Veriqloud/kiwi_pcb/README.md

# kiwi_pcb

Source code for the printed circuit boards. Open with KiCad. 

Contributing
------------

Please check out our [contributing guide](CONTRIBUTING.md) if you're interested in contributing.
