Veriqloud/kiwi_pcb/supply_interface/Production/supply_interface.csv

Source: | /home/lyes/kiwi_pcb/supply_interface/supply_interface.kicad_sch
Date: | Thu 11 Jun 2026 03:27:28 PM CEST
Tool: | Eeschema 7.0.11+dfsg-1build4
Generator: | /usr/share/kicad/plugins/bom_csv_grouped_by_value.py
Component Count: | 59
Collated Components:
Item | Qty | Reference(s) | Value | LibPart | Footprint | Datasheet | DNP | Arrow Part Number | Arrow Price/Stock | Description | Height | Manufacturer_Name | Manufacturer_Part_Number | Mouser Part Number | Mouser Price/Stock
1 | 8 | C1, C2, C11, C14, C17, C20, C23, C26 | 100 uF | T55D107M025C0060:T55D107M025C0060 | CAPPM7343X310N | https://www.mouser.in/datasheet/2/427/VISH_S_A0011791766_1-2571805.pdf |  |  |  | Tantalum Capacitors - Polymer 100uF 25volts 20% D Case 60 Max.ESR | 3.1 | Vishay | T55D107M025C0060 | 74-T55D107M025C0060 | https://www.mouser.co.uk/ProductDetail/Vishay-Sprague/T55D107M025C0060?qs=iR2ablhfrmEk%252B%2Fi%2Ffn01KQ%3D%3D
2 | 2 | C3, C4 | CL21A226MAYNNNE | CL21A226MAYNNNE:CL21A226MAYNNNE | CAPC2012X145N | http://product.samsungsem.com/mlcc/CL21A226MAYNNN.do |  |  |  | Multilayer Ceramic Capacitors MLCC - SMD/SMT 22uF+/-20% 25V X5R 2012 | 1.45 | SAMSUNG | CL21A226MAYNNNE | 187-CL21A226MAYNNNE | https://www.mouser.co.uk/ProductDetail/Samsung-Electro-Mechanics/CL21A226MAYNNNE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
3 | 6 | C9, C12, C15, C18, C21, C24 | 1 uF | GRM155R6YA105ME11J:GRM155R6YA105ME11J | GRM15x | https://search.murata.co.jp/Ceramy/image/img/A01X/G101/ENG/GRM155R6YA105ME11-01A.pdf |  |  |  |  | 0.33 | Murata Electronics | GRM155R6YA105ME11J | 81-GRM155R6YA105ME1J | https://www.mouser.co.uk/ProductDetail/Murata-Electronics/GRM155R6YA105ME11J?qs=F5EMLAvA7IDJM4M38SocmA%3D%3D
4 | 6 | C10, C13, C16, C19, C22, C25 | 22 uF | CL21A226MAYNNNE:CL21A226MAYNNNE | CAPC2012X145N | http://product.samsungsem.com/mlcc/CL21A226MAYNNN.do |  |  |  | Multilayer Ceramic Capacitors MLCC - SMD/SMT 22uF+/-20% 25V X5R 2012 | 1.45 | SAMSUNG | CL21A226MAYNNNE | 187-CL21A226MAYNNNE | https://www.mouser.co.uk/ProductDetail/Samsung-Electro-Mechanics/CL21A226MAYNNNE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
5 | 5 | D1, D2, D3, D4, D5 | TVS 12V | ATV02W150-HF:ATV02W150-HF | SODFL3718X130N | https://www.comchiptech.com/admin/files/product/ATV02W-HF%20series%20RevC.pdf |  |  |  |  | 1.3 | Comchip Technology | ATV02W150-HF | 750-ATV02W150-HF | https://www.mouser.co.uk/ProductDetail/Comchip-Technology/ATV02W150-HF?qs=vdiGlTBG6JsN1%252BHxsccr7w%3D%3D
6 | 1 | D6 | SMF6V0TR | SMF6V0TR:SMF6V0TR | SMF6V0TR | https://fscdn.rohm.com/en/products/databook/datasheet/discrete/diode/zener/smf6v0tr-e.pdf |  |  |  |  | 0.9 | ROHM Semiconductor | SMF6V0TR | 755-SMF6V0TR | https://www.mouser.co.uk/ProductDetail/ROHM-Semiconductor/SMF6V0TR/?qs=HXFqYaX1Q2yrPonInUPTeA%3D%3D
7 | 1 | D7 | DFLT27A-7 | DFLT27A-7:DFLT27A-7 | DFLT27A7 | https://www.diodes.com//assets/Datasheets/DFLT5V0A_DFLT220A.pdf |  |  |  |  | 1 | Diodes Incorporated | DFLT27A-7 | 621-DFLT27A-7 | https://www.mouser.co.uk/ProductDetail/Diodes-Incorporated/DFLT27A-7?qs=6ARB0lp6jlVvGDG5Fitq6g%3D%3D
8 | 1 | F1 | SF-0603S100-2 | SF-0603S100-2:SF-0603S100-2 | FUSC1608X55N | https://www.arrow.com/en/products/sf-0603s100-2/bourns |  |  |  |  | 0.55 | Bourns | SF-0603S100-2 | 652-SF-0603S100-2 | https://www.mouser.co.uk/ProductDetail/Bourns/SF-0603S100-2?qs=GIQXYiEeHGDLNhFbhYWnxw%3D%3D
9 | 1 | F2 | 3403.0157.24 | 3403.0157.24:3403.0157.24 | 3403015724 | https://www.schurter.com/en/datasheet/UMT_250 |  |  |  |  | 3 | SCHURTER | 3403.0157.24 | 693-3403.0157.24 | https://www.mouser.co.uk/ProductDetail/Schurter/3403015724/?qs=NiH9xeYC%252BKjhNprJ4TsRCQ%3D%3D
10 | 1 | F3 | SF-1206S300-2 | SF-1206S300-2:SF-1206S300-2 | FUSC3116X70N | https://www.arrow.com/en/products/sf-1206s400-2/bourns |  |  |  |  | 0.7 | Bourns | SF-1206S300-2 | 652-SF-1206S300-2 | https://www.mouser.co.uk/ProductDetail/Bourns/SF-1206S300-2?qs=GIQXYiEeHGDYZ4XcjkatwA%3D%3D
11 | 1 | F4 | SF-1206S1000R-2 | SF-1206S1000R-2:SF-1206S1000R-2 | FUSC3216X90N | https://www.bourns.com/docs/Product-Datasheets/SF-1206S-R.pdf |  |  |  |  | 0.9 | Bourns | SF-1206S1000R-2 | 652-SF-1206S1000R-2 | https://www.mouser.co.uk/ProductDetail/Bourns/SF-1206S1000R-2?qs=QpmGXVUTftGXxpZRDDQNPQ%3D%3D
12 | 1 | F5 | 049401.5NRHF | 049401_5NRHF:049401.5NRHF | 0494015NRHF | https://componentsearchengine.com/Datasheets/1/049401.5NRHF.pdf |  |  |  |  | 0.305 | LITTELFUSE | 049401.5NRHF | 576-049401.5NRHF | https://www.mouser.com/Search/Refine.aspx?Keyword=576-049401.5NRHF
13 | 1 | F6 | 0494002.NRHF | 0494002_NRHF:0494002.NRHF | FUSC1608X30N | http://www.littelfuse.com/~/media/electronics/datasheets/fuses/littelfuse_fuse_494_datasheet.pdf.pdf |  |  |  |  | 0.305 | LITTELFUSE | 0494002.NRHF | 576-0494002.NRHF | https://www.mouser.co.uk/ProductDetail/Littelfuse/0494002.NRHF?qs=zMpzAB%2FftDdhMQDursUq6Q%3D%3D
14 | 2 | F7, F11 | 3413.0329.22 | 3413.0329.22:3413.0329.22 | FUSC3216X60N | https://www.schurter.com/en/datasheet/UST_1206 |  |  |  |  | 0.6 | SCHURTER | 3413.0329.22 | 693-3413.0329.22 | https://www.mouser.co.uk/ProductDetail/Schurter/3413032922?qs=tk5EcTX4n4wCoEf0rBtliQ%3D%3D
15 | 2 | F8, F10 | 0ABA-0200-TN | 0ABA-0200-TN:0ABA-0200-TN | 0ABA0200TN | https://www.mouser.fr/datasheet/3/191/1/ds_cp_0aba_series.pdf |  |  |  |  | 0.5 | Bel Circuit Protection | 0ABA-0200-TN
16 | 1 | F9 | SF-0603SP080-2 | SF-0603SP080-2:SF-0603SP080-2 | FUSC1608X55N | https://www.mouser.fr/datasheet/3/40/1/SF_0603SP.pdf |  | SF-0603SP080-2 | https://www.arrow.com/en/products/sf-0603sp080-2/bourns?region=nac |  | 0.55 | Bourns | SF-0603SP080-2 | 652-SF-0603SP080-2 | https://www.mouser.co.uk/ProductDetail/Bourns/SF-0603SP080-2?qs=pxDZlBjcsChFLlq9LzvJZQ%3D%3D
17 | 4 | H1, H2, H3, H4 | MountingHole | Mechanical:MountingHole | MountingHole:MountingHole_3mm_Pad_Via | ~
18 | 1 | J1 | 39-28-1243 | 39-28-1243:39-28-1243 | 39-28-1243 | https://www.molex.com/pdm_docs/sd/039281023_sd.pdf |  |  |  | 24 way vertical PCB header,Mini-Fit Jr Molex MINI-FIT JR. Series, Series Number 5566, 4.2mm Pitch 24 Way 2 Row Straight PCB Header, Solder Termination, 6A | 12.8 | Molex | 39-28-1243 | 538-39-28-1243 | https://www.mouser.co.uk/ProductDetail/Molex/39-28-1243?qs=4XSMV6Twtb0I%2F4%252BTTSJFbg%3D%3D
19 | 2 | J2, J7 | 39-28-1043 | 39-28-1043:39-28-1043 | 39-28-1043 | https://www.molex.com/pdm_docs/sd/039281023_sd.pdf |  |  |  | Mini-Fit Jr. Vertical Header, 4.20mm Pitch, Dual Row, 4 Circuits, without Snap-in Plastic Peg PCB Lock, Tin, Natural | 12.8 | Molex | 39-28-1043 | 538-39-28-1043 | https://www.mouser.co.uk/ProductDetail/Molex/39-28-1043?qs=LQQHZ4xw2XCMHoV0KRLGhg%3D%3D
20 | 9 | J3, J4, J6, J8, J9, J10, J11, J12, J13 | MBES-152 | MBES-152:MBES-152 | CONN_MBES-152_ALT | MBES-152
21 | 1 | J5 | 282837-3 | 282837-3:282837-3 | 2828373 |  |  |  |  | Fixed Terminal Blocks 5.08MM PCB MOUNT 3P | 10.3 | TE Connectivity | 282837-3 | 571-2828373 | https://www.mouser.co.uk/ProductDetail/TE-Connectivity/282837-3?qs=A%252Bip%252BNCYi6PMRxtBYEOSrQ%3D%3D
22 | 1 | J15 | 3-641215-2 | 3-641215-2:3-641215-2 | SHDR2W66P0X254_1X2_508X572X813P | http://www.te.com/usa-en/product-3-641215-2.html#guest-click |  |  |  |  | 8.128 | TE Connectivity | 3-641215-2 | 571-3-641215-2 | https://www.mouser.co.uk/ProductDetail/TE-Connectivity-AMP/3-641215-2?qs=KRfK61YovsgAMFXR0HUBMw%3D%3D
23 | 1 | PS1 | TEL_15-1215N | TEL_15-1215N:TEL_15-1215N | TEL151215N | https://tracopower.com/tel15n-datasheet/ |  |  |  | 15 Watt DC/DC converter, industrial, 2:1 input, ultra compact design, encapsulated, DIP-16 metal package | 10.7 | Traco Power | TEL 15-1215N | 495-TEL15-1215N | https://www.mouser.co.uk/ProductDetail/TRACO-Power/TEL-15-1215N?qs=T%252BzbugeAwjjLZBJJlIkfGQ%3D%3D
