Veriqloud/kiwi_pcb/MB/3D/TEN_40-2422E.stp

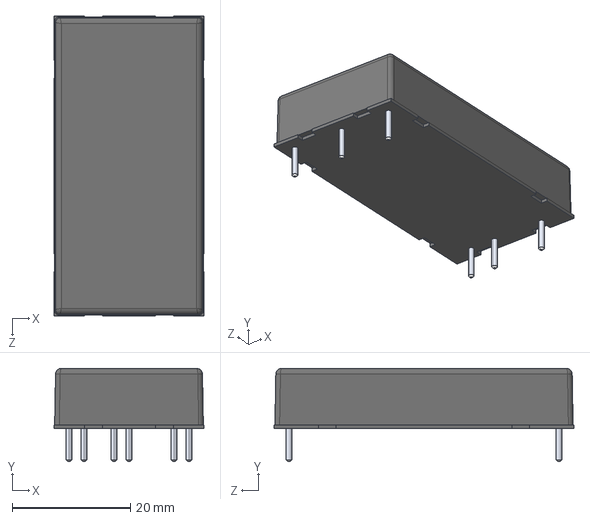
[picture p1: CAD file, 2024-12-13]
MB/3D/TEN_40-2422E.stp
25.4 x 15.8 x 50.8 mm
