Veriqloud/kiwi_pcb/MB/3D/T55D107M025C0060.stp

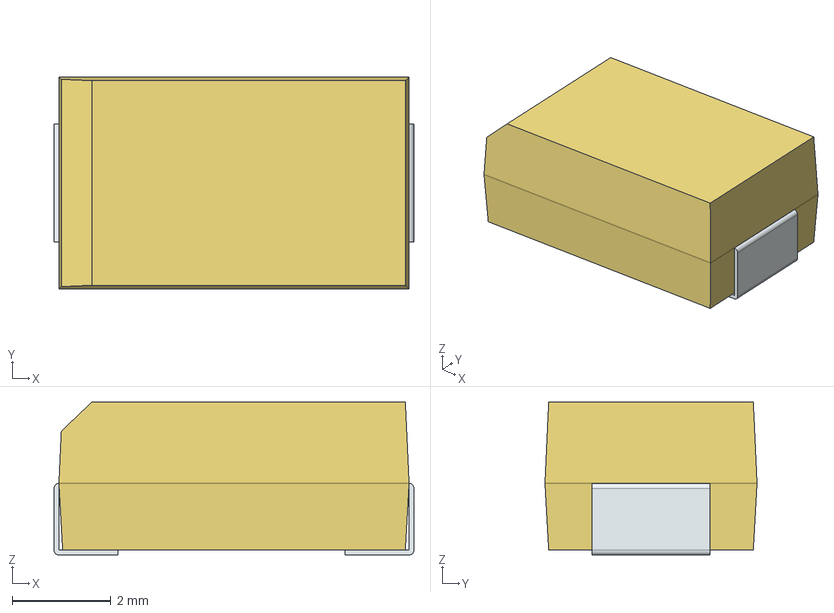
[picture p2: CAD file, 2024-12-13]
MB/3D/T55D107M025C0060.stp
7.30 x 4.30 x 3.10 mm
FilletPin1
FilletPin2
