Veriqloud/kiwi_pcb/MB/3D/PQQ10W-Q24-S3-S.stp

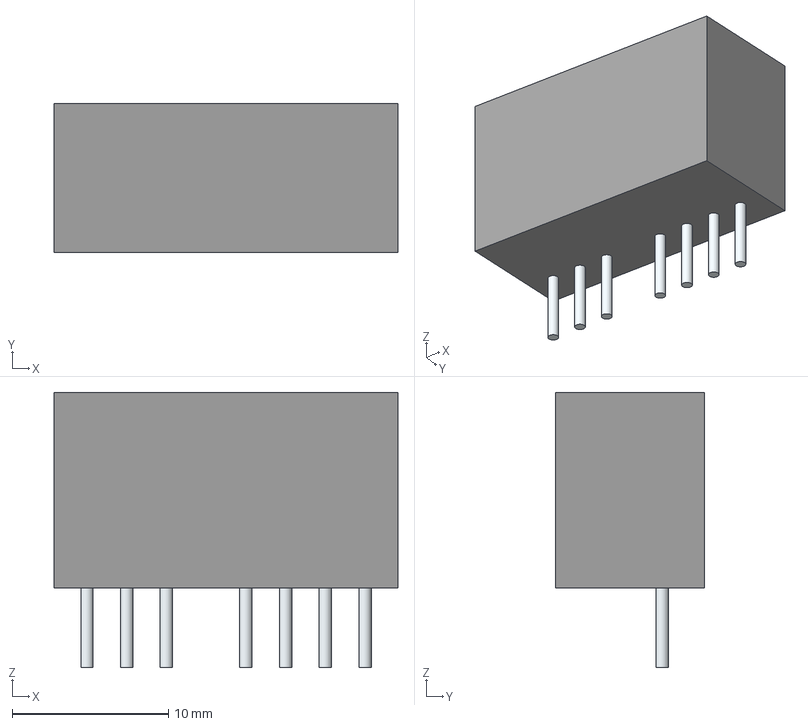
[picture p3: CAD file, 2024-12-13]
MB/3D/PQQ10W-Q24-S3-S.stp
22.0 x 9.50 x 17.6 mm
Leads
