Veriqloud/kiwi_pcb/MB/3D/39-28-1043.stp

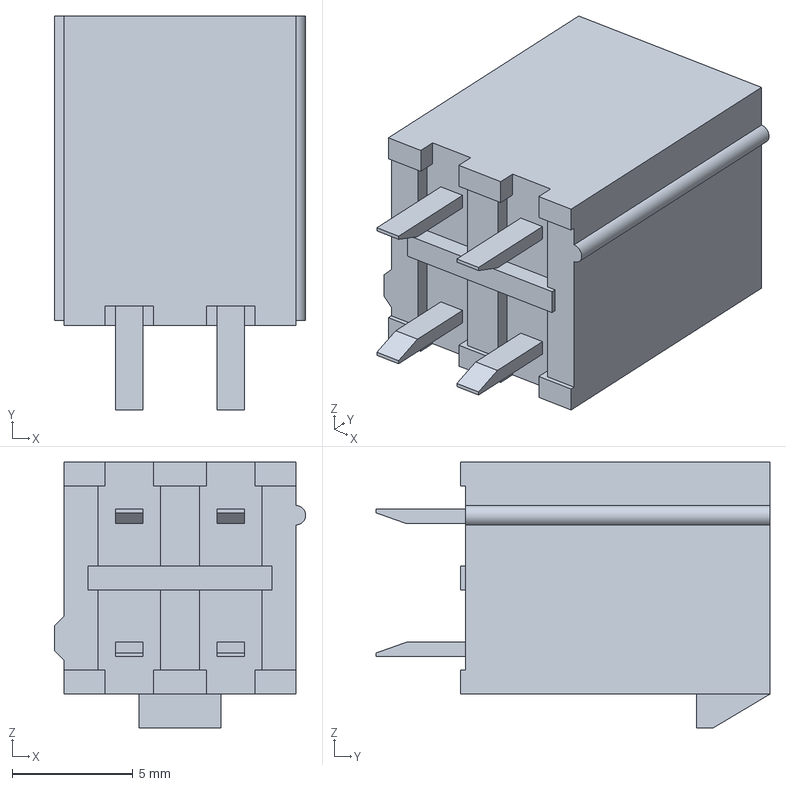
[picture p4: CAD file, 2024-12-13]
MB/3D/39-28-1043.stp
10.4 x 16.3 x 11.0 mm
