Veriqloud/kiwi_pcb/MB/3D/GRM31CR61E476ME44K.stp

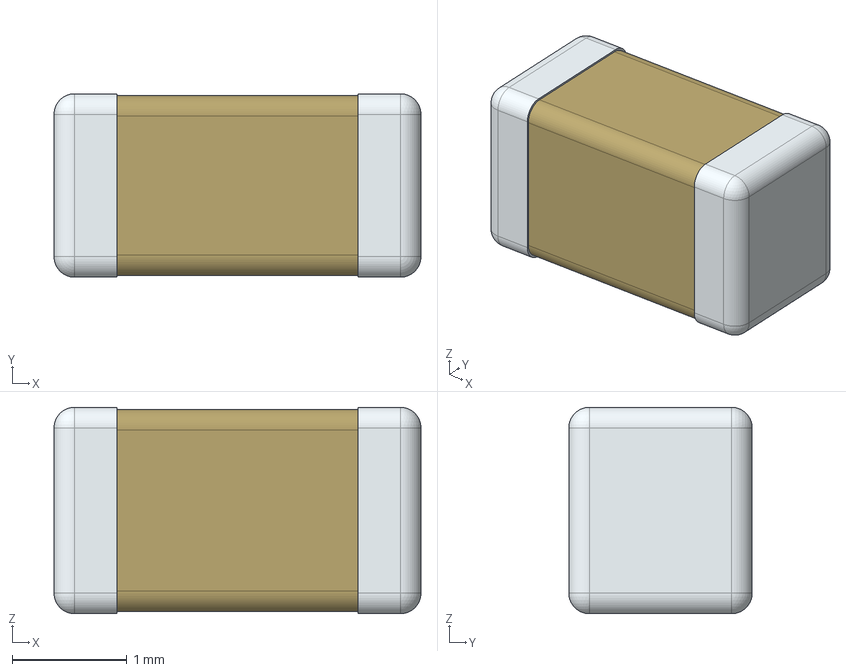
[picture p5: CAD file, 2024-12-13]
MB/3D/GRM31CR61E476ME44K.stp
3.20 x 1.60 x 1.80 mm
