Veriqloud/kiwi_pcb/MB/3D/GRM21BR61E226ME44K.stp

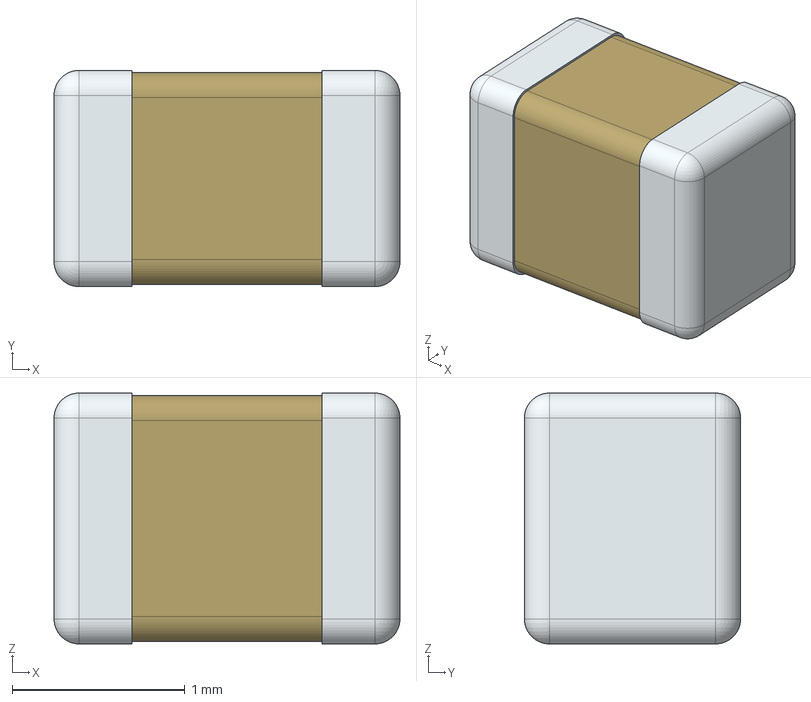
[picture p6: CAD file, 2024-12-13]
MB/3D/GRM21BR61E226ME44K.stp
2.00 x 1.25 x 1.45 mm
