Veriqloud/kiwi_pcb/MB/3D/PDQE15-Q24-S5-D.stp

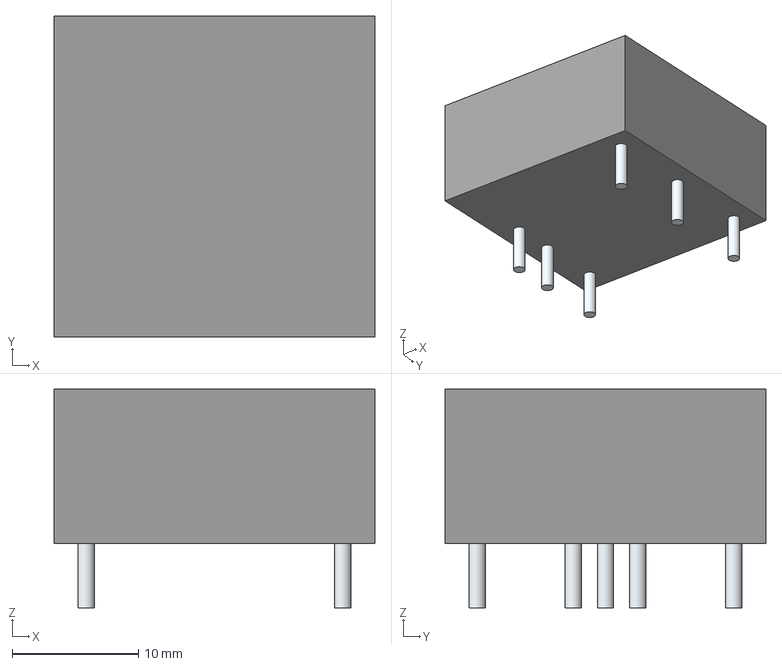
[picture p7: CAD file, 2024-12-13]
MB/3D/PDQE15-Q24-S5-D.stp
25.4 x 25.4 x 17.3 mm
Leads
