Veriqloud/kiwi_pcb/MB/3D/PJ-082BH.stp

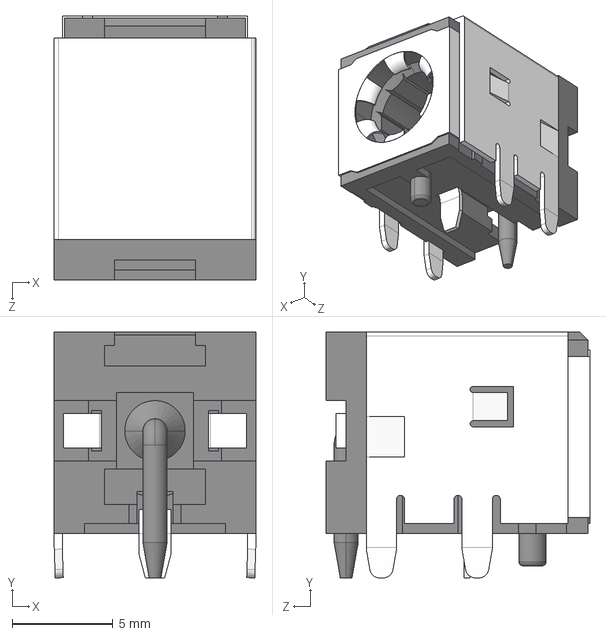
[picture p8: CAD file, 2024-12-13]
MB/3D/PJ-082BH.stp
10.0 x 12.2 x 13.1 mm
