Veriqloud/kiwi_pcb/MB/3D/TEL_15-1215N.stp

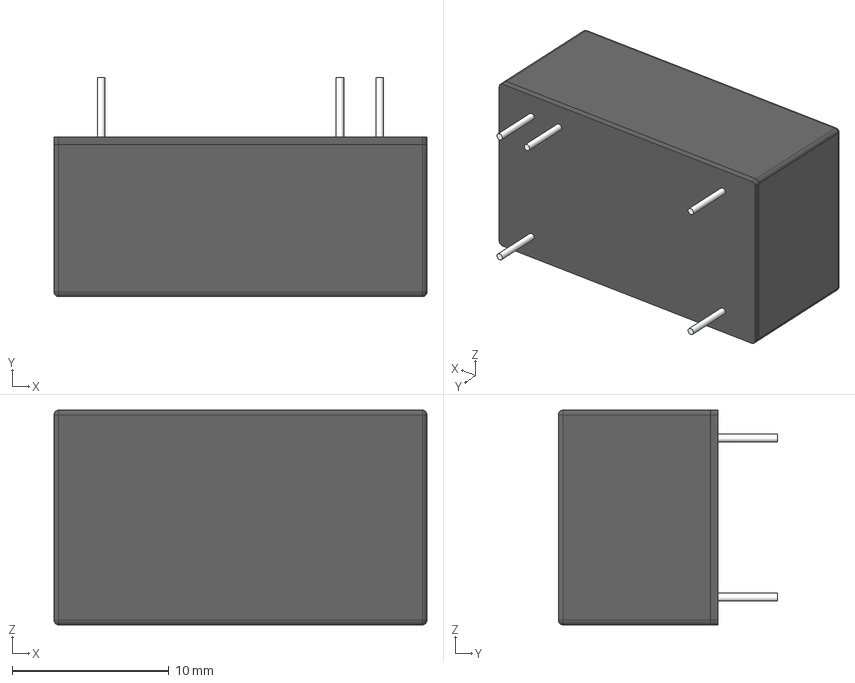
[picture p9: CAD file, 2024-12-13]
MB/3D/TEL_15-1215N.stp
23.8 x 14.0 x 13.7 mm
