Veriqloud/kiwi_pcb/MB/3D/UWT1V221MNL1GS.stp

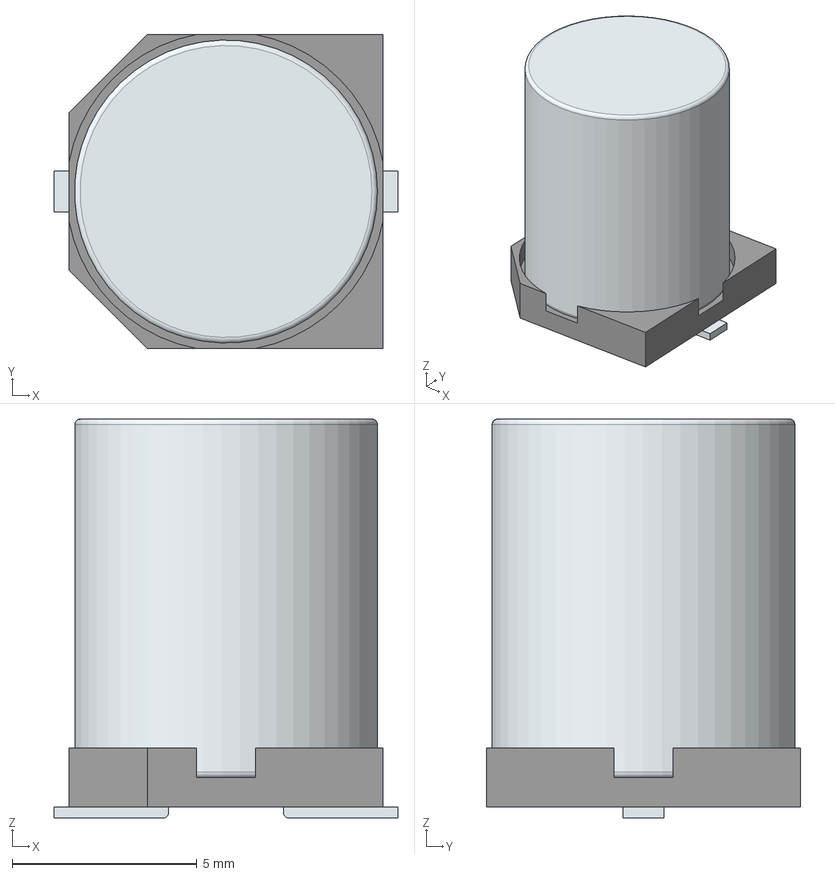
[picture p10: CAD file, 2024-12-13]
MB/3D/UWT1V221MNL1GS.stp
9.30 x 8.50 x 10.8 mm
Base
Pin1Fillet
Pin2Fillet
