Veriqloud/kiwi_pcb/MB/3D/39-28-1243.stp

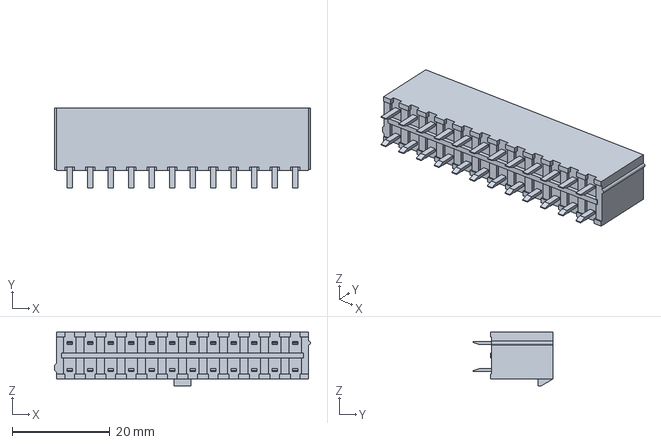
[picture p11: CAD file, 2024-12-13]
MB/3D/39-28-1243.stp
52.4 x 16.3 x 11.0 mm
