Veriqloud/kiwi_pcb/MB/3D/282837-3.stp

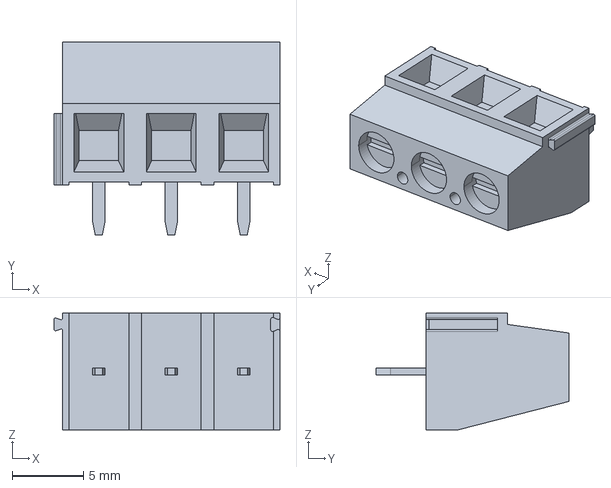
[picture p12: CAD file, 2024-12-13]
MB/3D/282837-3.stp
15.8 x 13.5 x 8.20 mm
