Veriqloud/kiwi_pcb/MB/3D/10127820-0821LF.stp

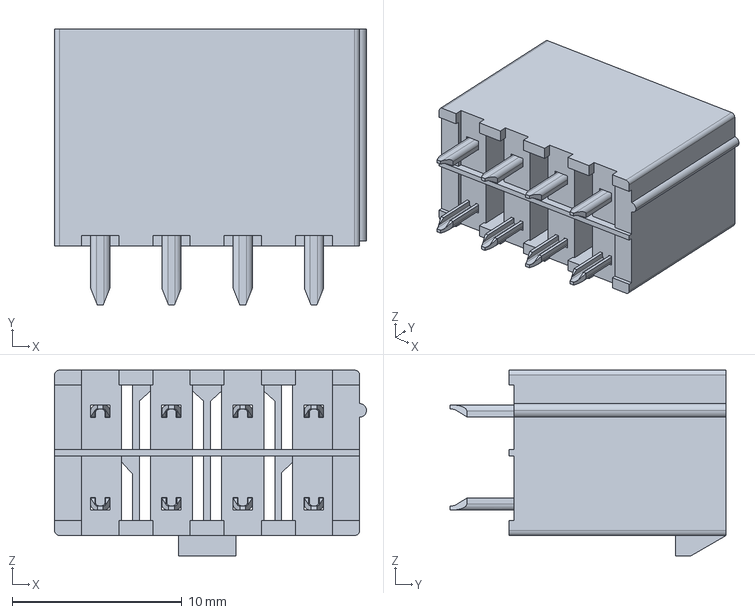
[picture p13: CAD file, 2024-12-13]
MB/3D/10127820-0821LF.stp
18.4 x 16.3 x 11.0 mm
