Veriqloud/kiwi_pcb/MB/3D/1725656.stp

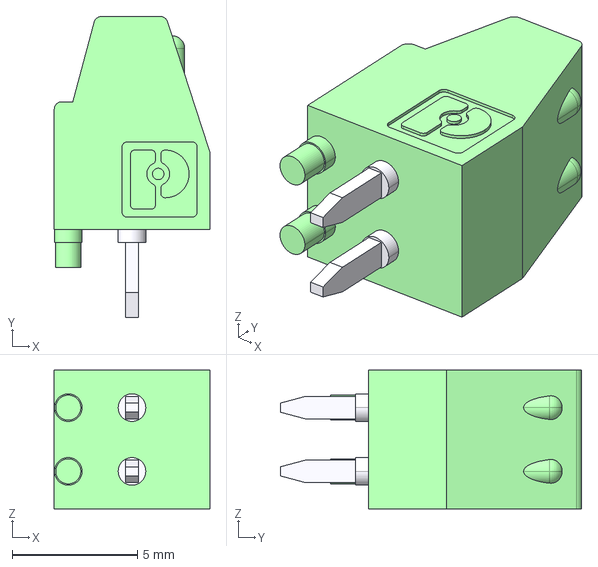
[picture p14: CAD file, 2024-12-13]
MB/3D/1725656.stp
6.20 x 12.0 x 5.54 mm
