Veriqloud/kiwi_pcb/MB/3D/MAX17577ATC+.stp

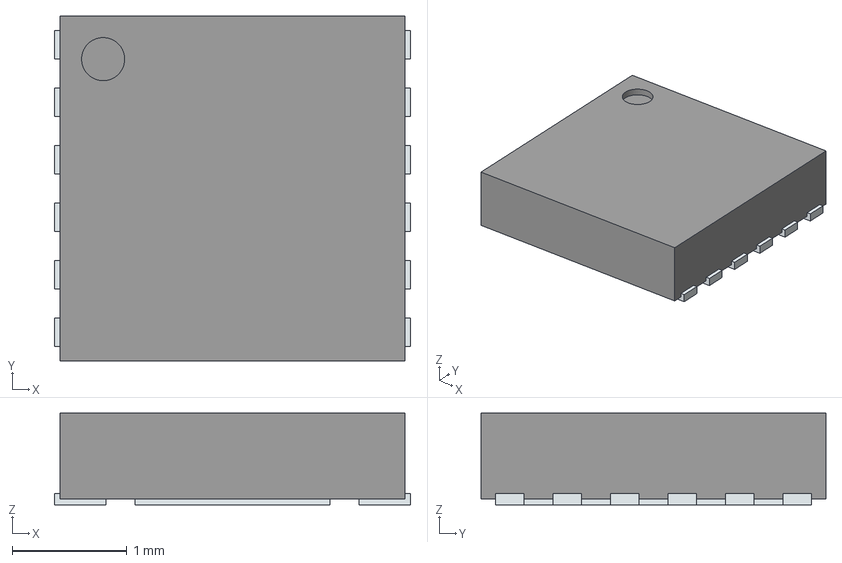
[picture p15: CAD file, 2024-12-13]
MB/3D/MAX17577ATC+.stp
3.10 x 3.00 x 0.8 mm
ThermalPin
PinsArrayLR
