Veriqloud/kiwi_pcb/(list of files, cad)

Other CAD files:
MB/3D/CL21A226MAYNNNE.stp
MB/3D/LMR50410XFDBVR.stp
