Veriqloud/kiwi_pcb/supply_interface/PDF/supply_interface.pdf

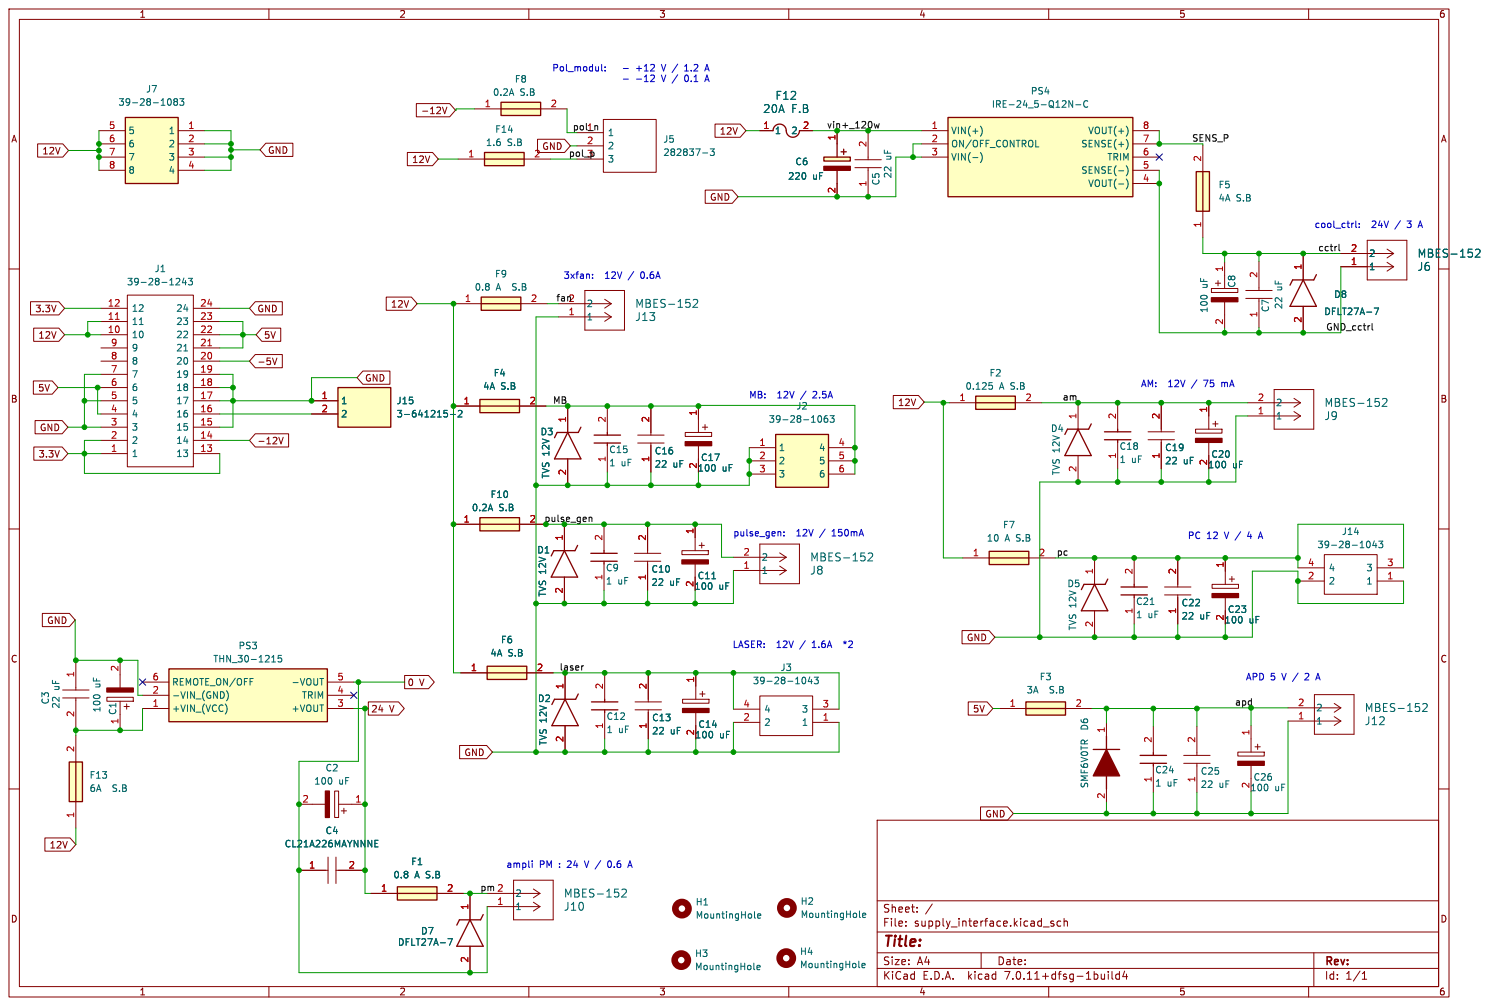
[picture p16: page 1]
