Veriqloud/kiwi_pcb/supply_interface/Production/GERBER/supply_interface-B_Cu.pdf

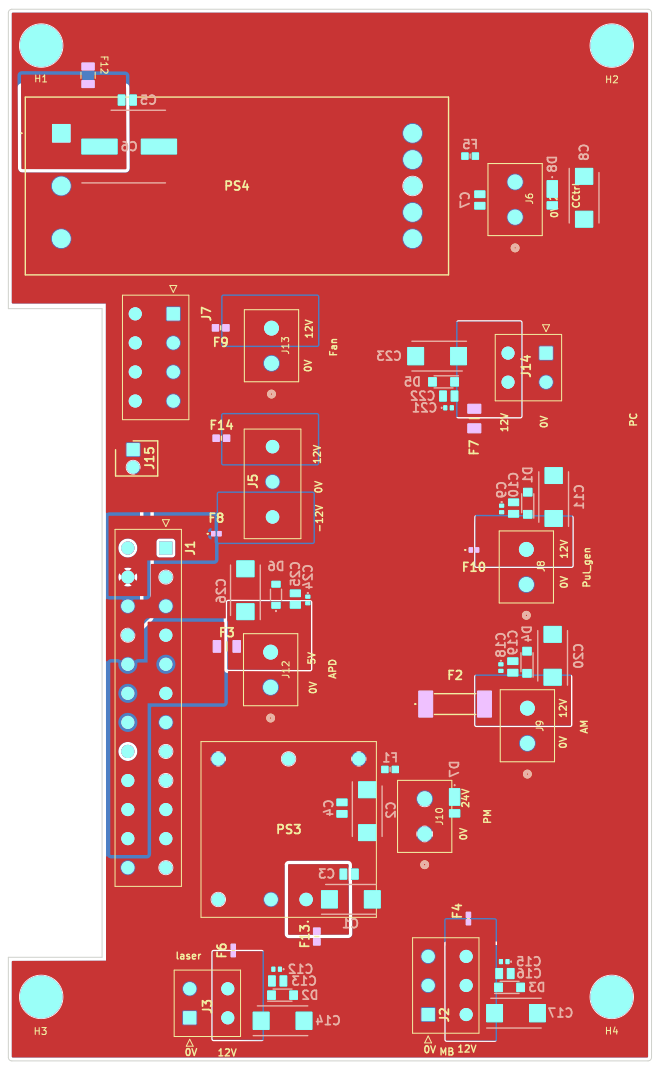
[picture p17: page 1]
