Veriqloud/kiwi_pcb/supply_interface/Production/GERBER/supply_interface-B_Mask.pdf

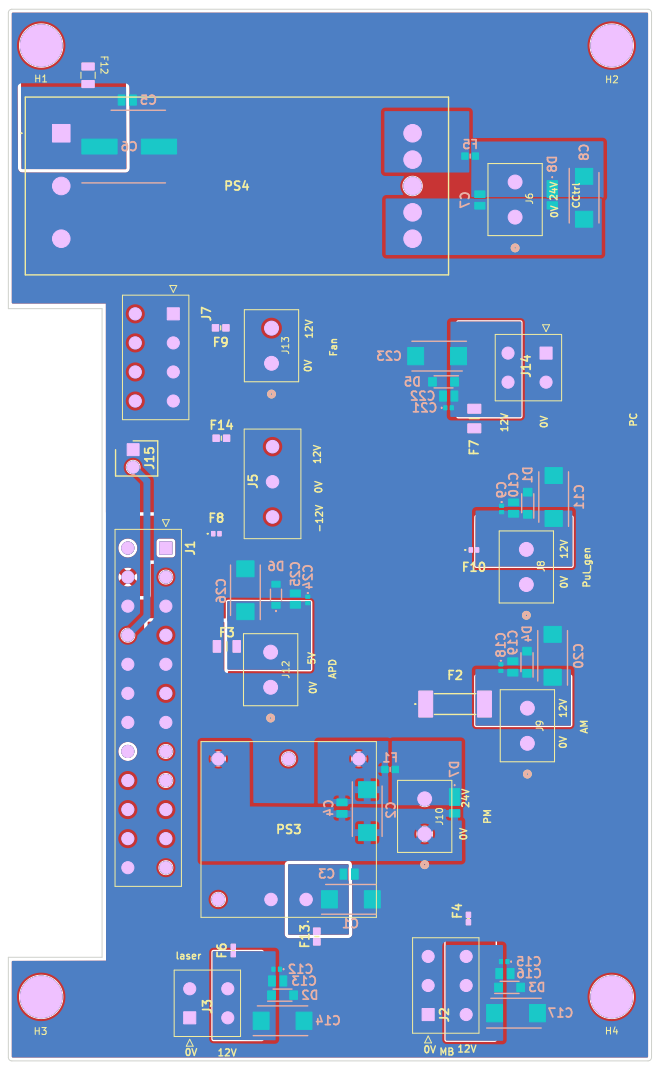
[picture p18: page 1]
