Veriqloud/kiwi_pcb/supply_interface/Production/GERBER/supply_interface-B_Paste.pdf

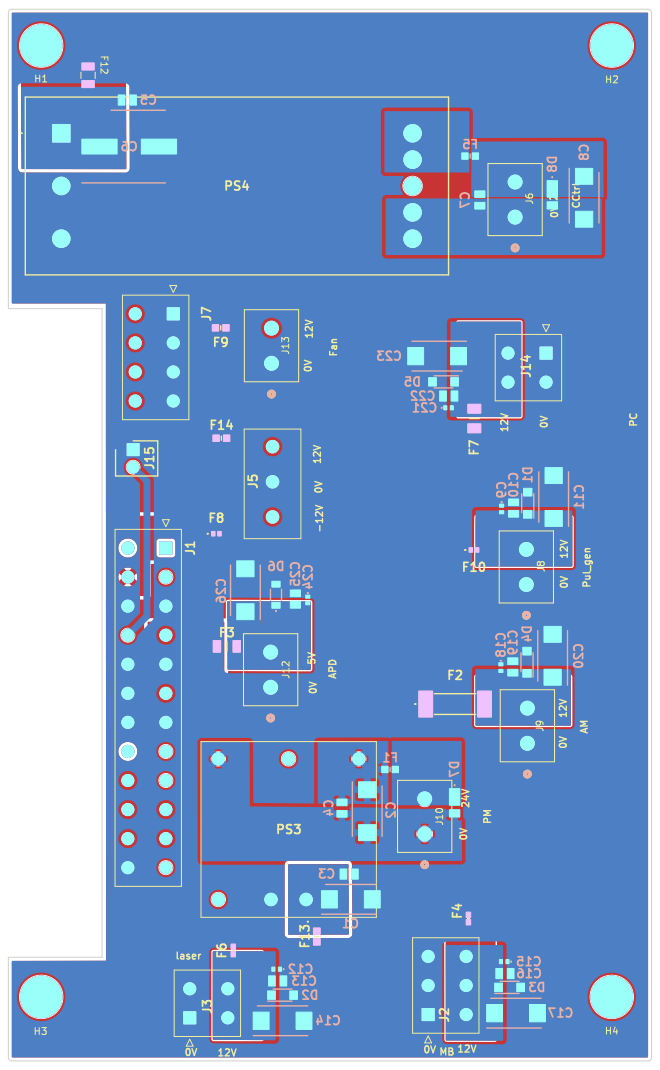
[picture p19: page 1]
