Veriqloud/kiwi_pcb/supply_interface/Production/GERBER/supply_interface-B_Silkscreen.pdf

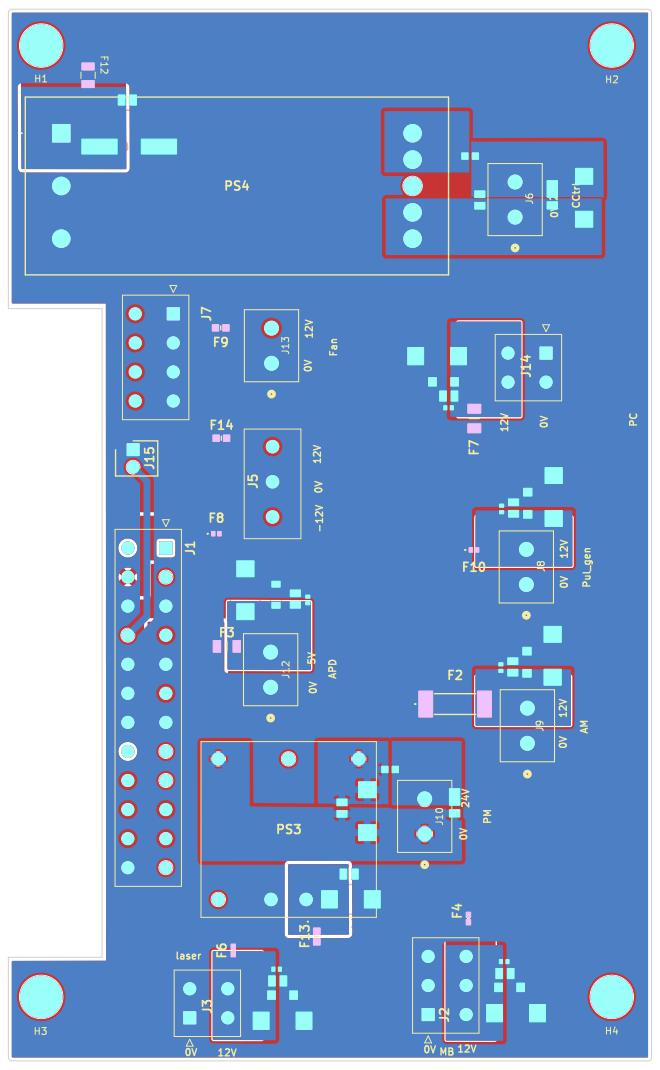
[picture p20: page 1]
