Veriqloud/kiwi_pcb/supply_interface/Production/GERBER/supply_interface-Edge_Cuts.pdf

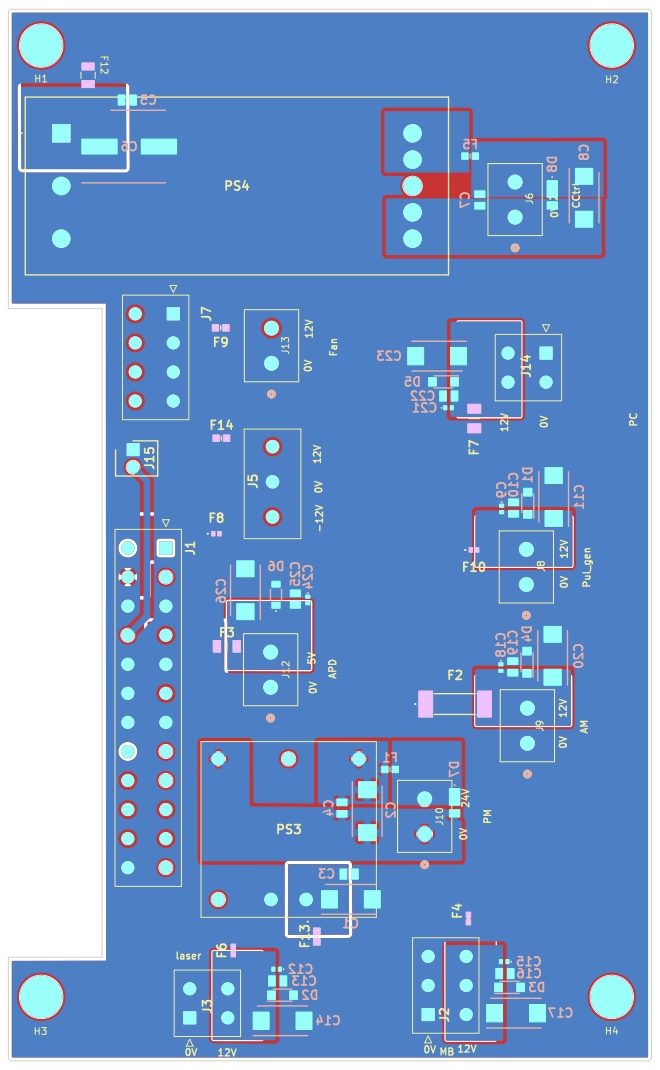
[picture p21: page 1]
