Veriqloud/kiwi_pcb/supply_interface/Production/GERBER/supply_interface-F_Mask.pdf

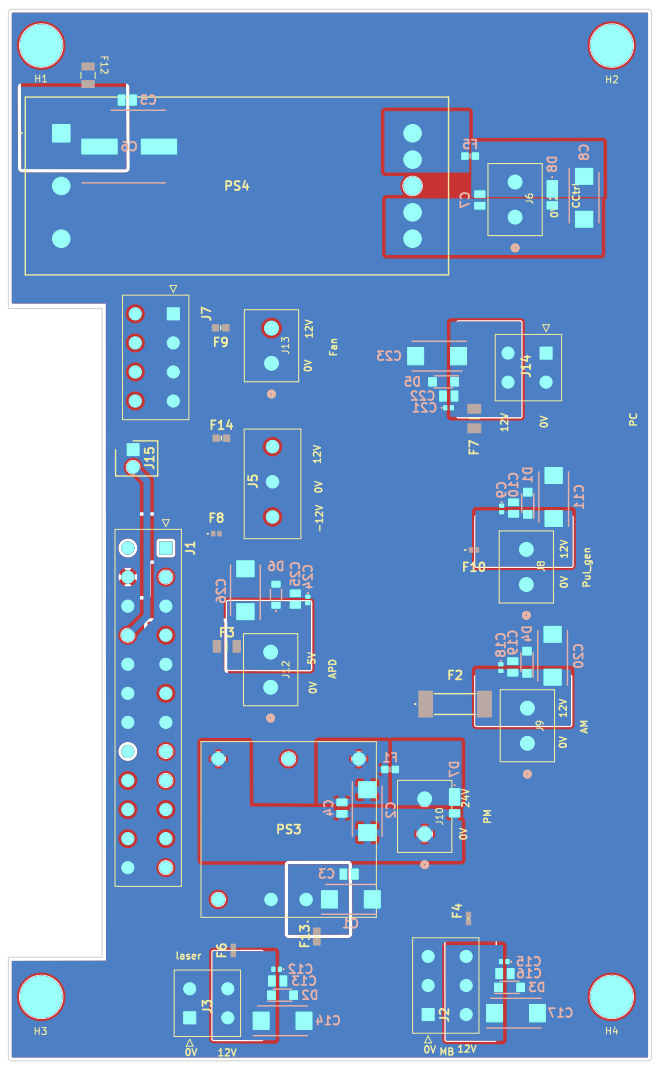
[picture p22: page 1]
