Veriqloud/kiwi_pcb/supply_interface/Production/GERBER/supply_interface-F_Paste.pdf

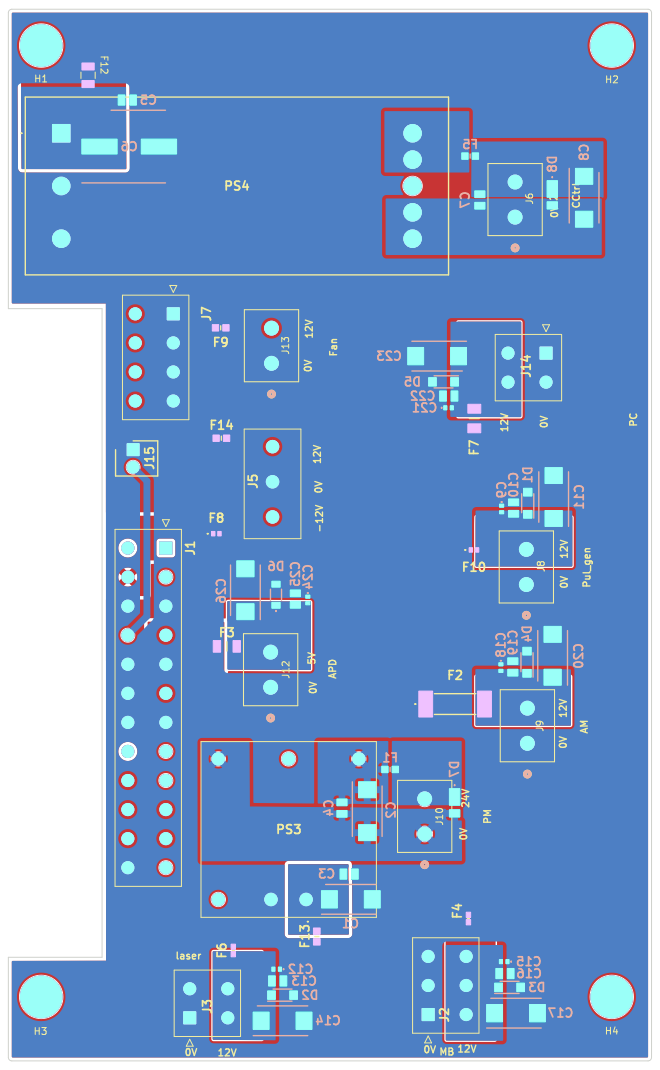
[picture p23: page 1]
