Veriqloud/kiwi_pcb/supply_interface/Production/GERBER/supply_interface-F_Silkscreen.pdf

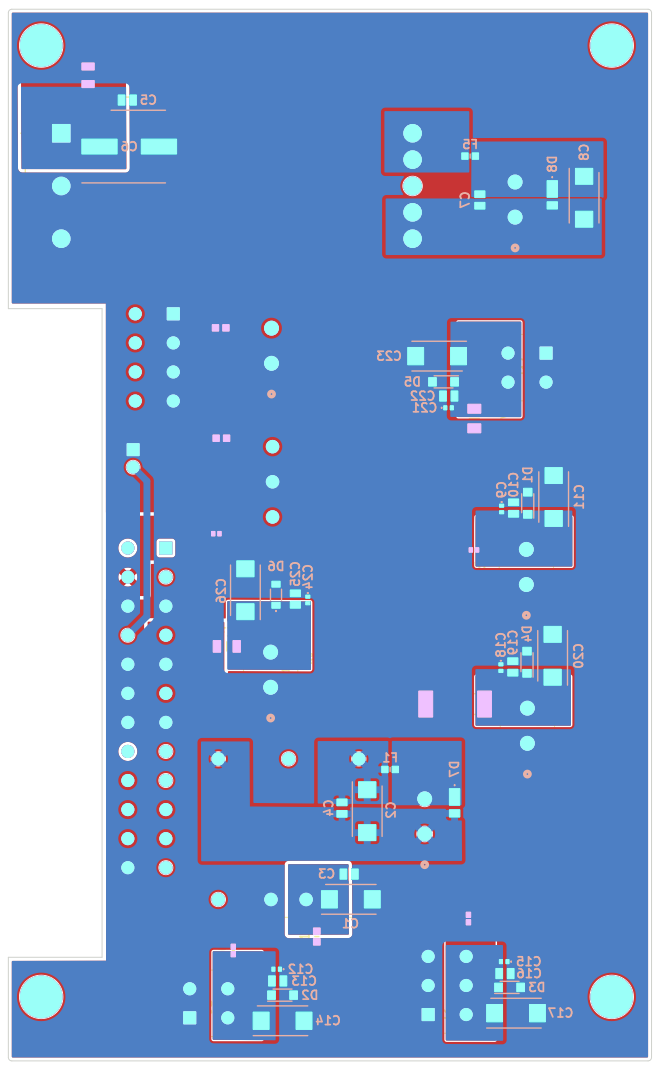
[picture p24: page 1]
