Veriqloud/kiwi_pcb/supply_interface/supply_interface.kicad_pcb

## KiCad design supply_interface/supply_interface.kicad_pcb (2026-07-27)

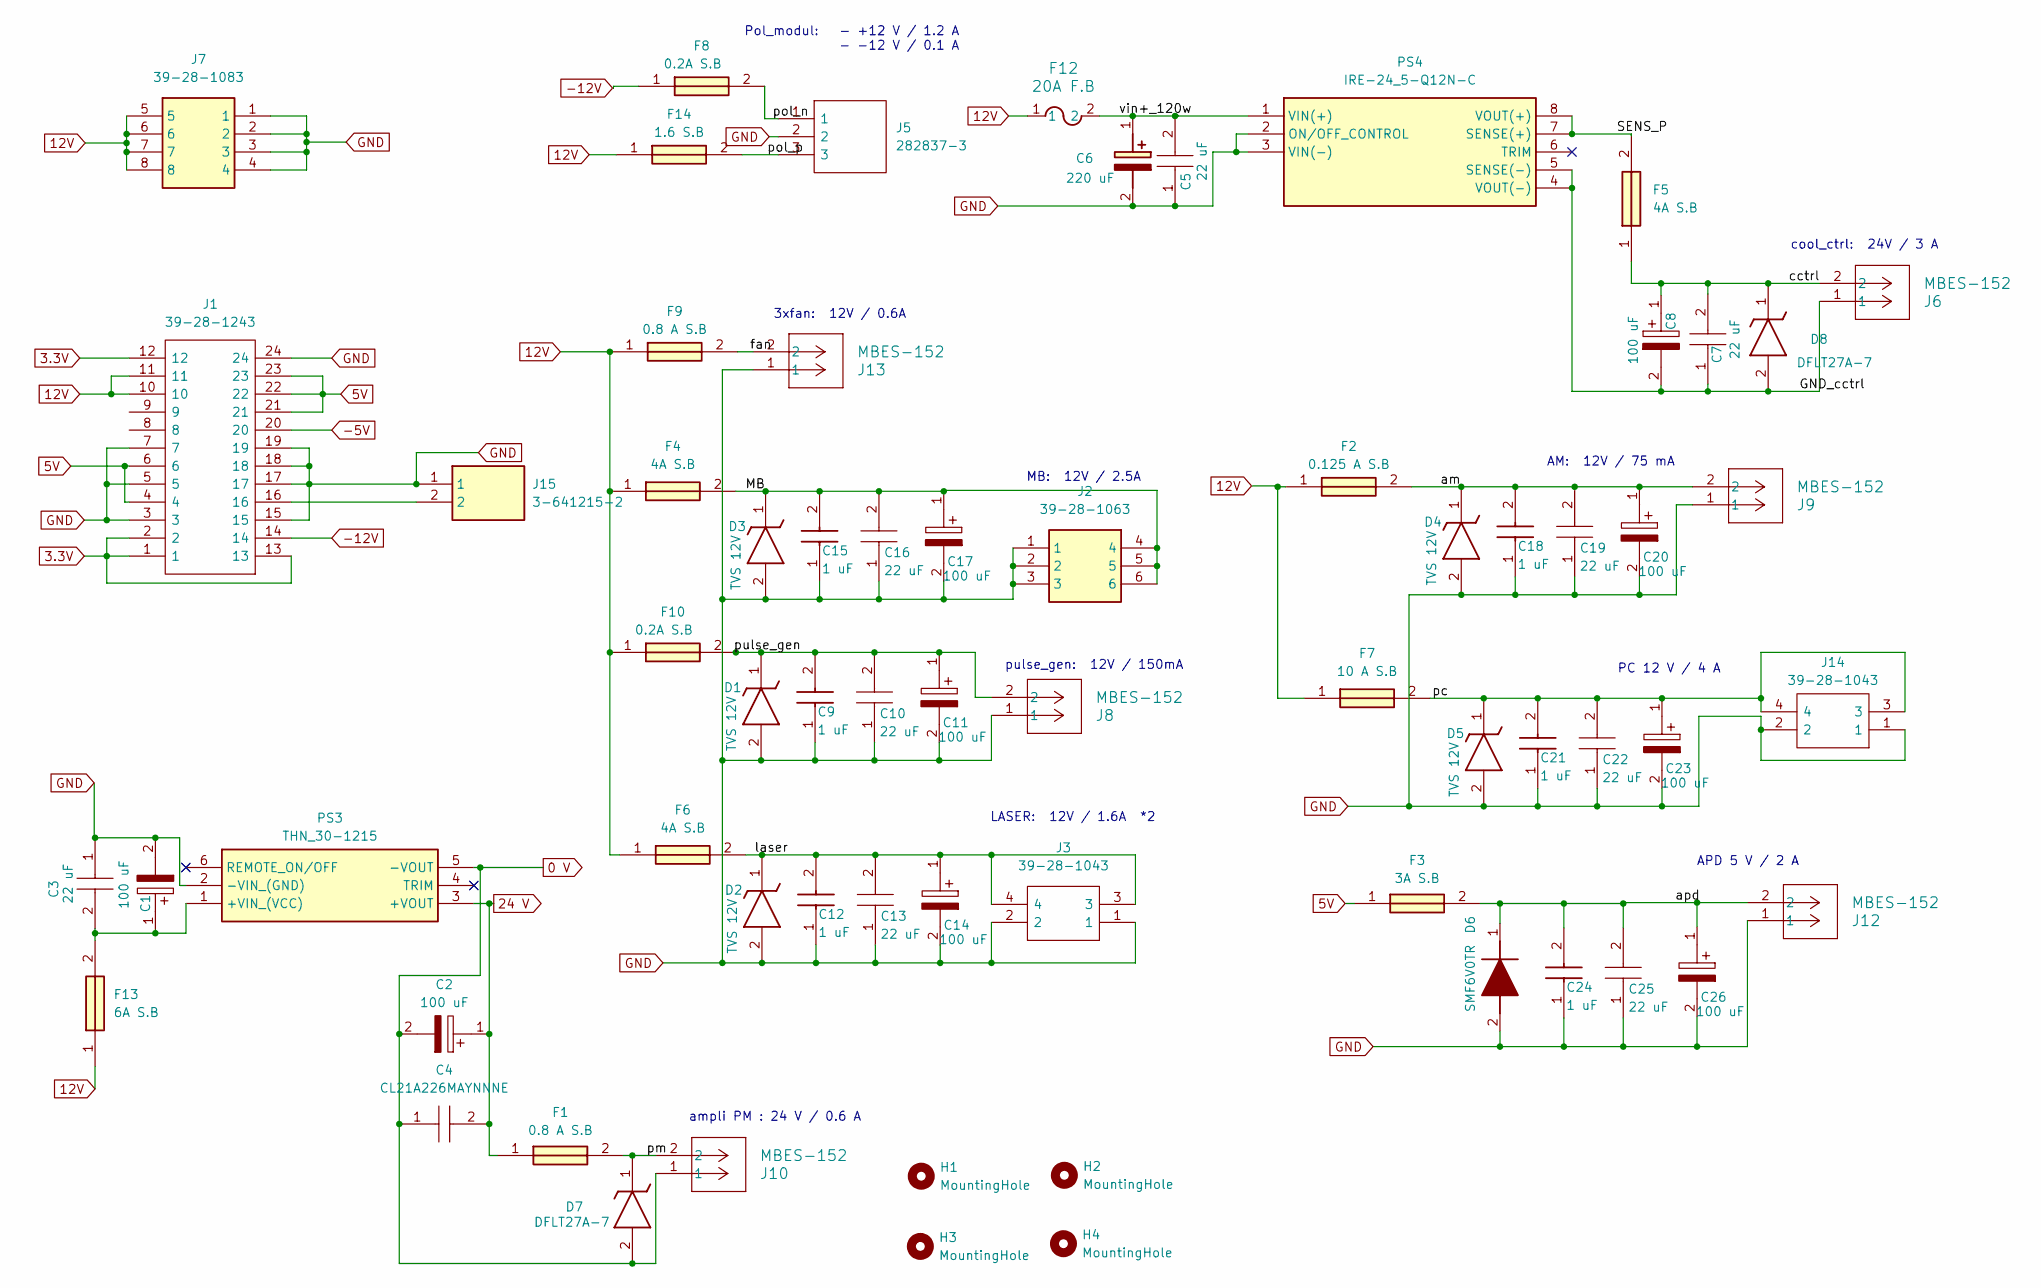
[picture p25: schematic supply_interface.kicad_sch]

Parts:
C1, C2, C8, C11, C14, C17, C20, C23, C26: 100 uF; CAPPM7343X310N; Manufacturer_Part_Number T55D107M025C0060; Mouser Part Number 74-T55D107M025C0060
C3, C5, C7, C10, C13, C16, C19, C22, C25: 22 uF; CAPC2012X145N; Mouser Part Number 187-CL21A226MAYNNNE
C4: CL21A226MAYNNNE; CAPC2012X145N; Mouser Part Number 187-CL21A226MAYNNNE
C6: 220 uF; CAPAE1050X1050N; Mouser Part Number 594-MAL215097001E3
C9, C12, C15, C18, C21, C24: 1 uF; GRM15x; Mouser Part Number 81-GRM155R6YA105ME1J
D1, D2, D3, D4, D5: TVS 12V; SODFL3718X130N; Mouser Part Number 750-ATV02W150-HF
D6: SMF6V0TR; Mouser Part Number 755-SMF6V0TR
D7, D8: DFLT27A-7; DFLT27A7; Mouser Part Number 621-DFLT27A-7
F1: 0.8 A S.B; FUSC1608X55N; Mouser Part Number 652-SF-0603S100-2
F2: 0.125 A S.B; 3403015724; Mouser Part Number 693-3403.0157.24
F3: 3A S.B; FUSC3116X70N; Mouser Part Number 652-SF-1206S300-2
F4, F6: 4A S.B; FUSC1005X61N; Mouser Part Number 652-SF-0402S400M-2
F5: 4A S.B; FUSC1608X55N; Mouser Part Number 652-SF-0603S400-2
F7: 10 A S.B; FUSC3216X90N; Mouser Part Number 652-SF-1206S1000R-2
F8, F10: 0.2A S.B; 0ABA0200TN; Manufacturer_Part_Number 0ABA-0200-TN
F9: 0.8 A S.B; FUSC1608X55N; Manufacturer_Part_Number SF-0603SP080-2; Mouser Part Number 652-SF-0603SP080-2
F12: 20A F.B; FUS_CB_3216FF
F13: 6A S.B; FUSC1608X95N; Mouser Part Number 652-SF-0603SA600M-2
F14: 1.6 S.B; FUSC1608X55N; Manufacturer_Part_Number SF-0603S160-2
H1, H2, H3, H4: MountingHole; MountingHole_3mm_Pad_Via
J1: 39-28-1243; Mouser Part Number 538-39-28-1243
J2: 39-28-1063; Mouser Part Number 538-39-28-1063
J3, J14: 39-28-1043; Mouser Part Number 538-39-28-1043
J5: 282837-3; 2828373; Mouser Part Number 571-2828373
J6, J8, J9, J10, J12, J13: MBES-152; CONN_MBES-152_ALT
J7: 39-28-1083; Mouser Part Number 538-39-28-1083
J15: 3-641215-2; SHDR2W66P0X254_1X2_508X572X813P; Mouser Part Number 571-3-641215-2
PS3: THN_30-1215; THN302415; Mouser Part Number 495-THN30-1215
PS4: IRE-24_5-Q12N-C; IRE245Q12NC; Mouser Part Number 580-IRE-24/5-Q12N-C

Connections:
0 V: C2.2, C4.1, D7.2 (A), J10.1, PS3.5 (-VOUT)
3.3V: J1.1, J1.2, J1.12, J1.13
5V: F3.1, J1.4, J1.6, J1.21, J1.22, J1.23
12V: F2.1, F4.1, F6.1, F7.1, F9.1, F10.1, F12.1, F13.1, F14.1, J1.10, J1.11, J7.5, J7.6, J7.7, J7.8
24 V: C2.1, C4.2, F1.1, PS3.3 (+VOUT)
-5V: J1.20
-12V: F8.1, J1.14
/GND_cctrl: C7.1, C8.2, D8.2 (A), J6.1, PS4.4 (VOUT(-)), PS4.5 (SENSE(-))
/MB: C15.2, C16.2, C17.1, D3.1 (K), F4.2, J2.4, J2.5, J2.6
/SENS_P: F5.2, PS4.7 (SENSE(+)), PS4.8 (VOUT(+))
/am: C18.2, C19.2, C20.1, D4.1 (K), F2.2, J9.2
/apd: C24.2, C25.2, C26.1, D6.1 (K), F3.2, J12.2
/cctrl: C7.2, C8.1, D8.1 (K), F5.1, J6.2
/fan: F9.2, J13.2
/laser: C12.2, C13.2, C14.1, D2.1 (K), F6.2, J3.3, J3.4
/pc: C21.2, C22.2, C23.1, D5.1 (K), F7.2, J14.3, J14.4
/pm: D7.1 (K), F1.2, J10.2
/pol_n: F8.2, J5.1
/pol_p: F14.2, J5.3
/pulse_gen: C9.2, C10.2, C11.1, D1.1 (K), F10.2, J8.2
/vin+_120w: C5.2, C6.1 (+), F12.2, PS4.1 (VIN(+))
GND: C1.2, C3.1, C5.1, C6.2 (-), C9.1, C10.1, C11.2, C12.1, C13.1, C14.2, C15.1, C16.1, C17.2, C18.1, C19.1, C20.2, C21.1, C22.1, C23.2, C24.1, C25.1, C26.2, D1.2 (A), D2.2 (A), D3.2 (A), D4.2 (A), D5.2 (A), D6.2 (A), J1.3, J1.5, J1.7, J1.15, J1.17, J1.18, J1.19, J1.24, J2.1, J2.2, J2.3, J3.1, J3.2, J5.2, J7.1, J7.2, J7.3, J7.4, J8.1, J9.1, J12.1, J13.1, J14.1, J14.2, J15.1, PS3.2 (-VIN_(GND)), PS4.2 (ON/OFF_CONTROL), PS4.3 (VIN(-))
unnamed: J1.16, J15.2
unnamed: C1.1, C3.2, F13.2, PS3.1 (+VIN_(VCC))

Notes on the sheet:
PC 12 V / 4 A
cool_ctrl: 24V / 3 A
3xfan: 12V / 0.6A
pulse_gen: 12V / 150mA
MB: 12V / 2.5A
Pol_modul: - +12 V / 1.2 A - -12 V / 0.1 A
LASER: 12V / 1.6A *2
AM: 12V / 75 mA
APD 5 V / 2 A
ampli PM : 24 V / 0.6 A

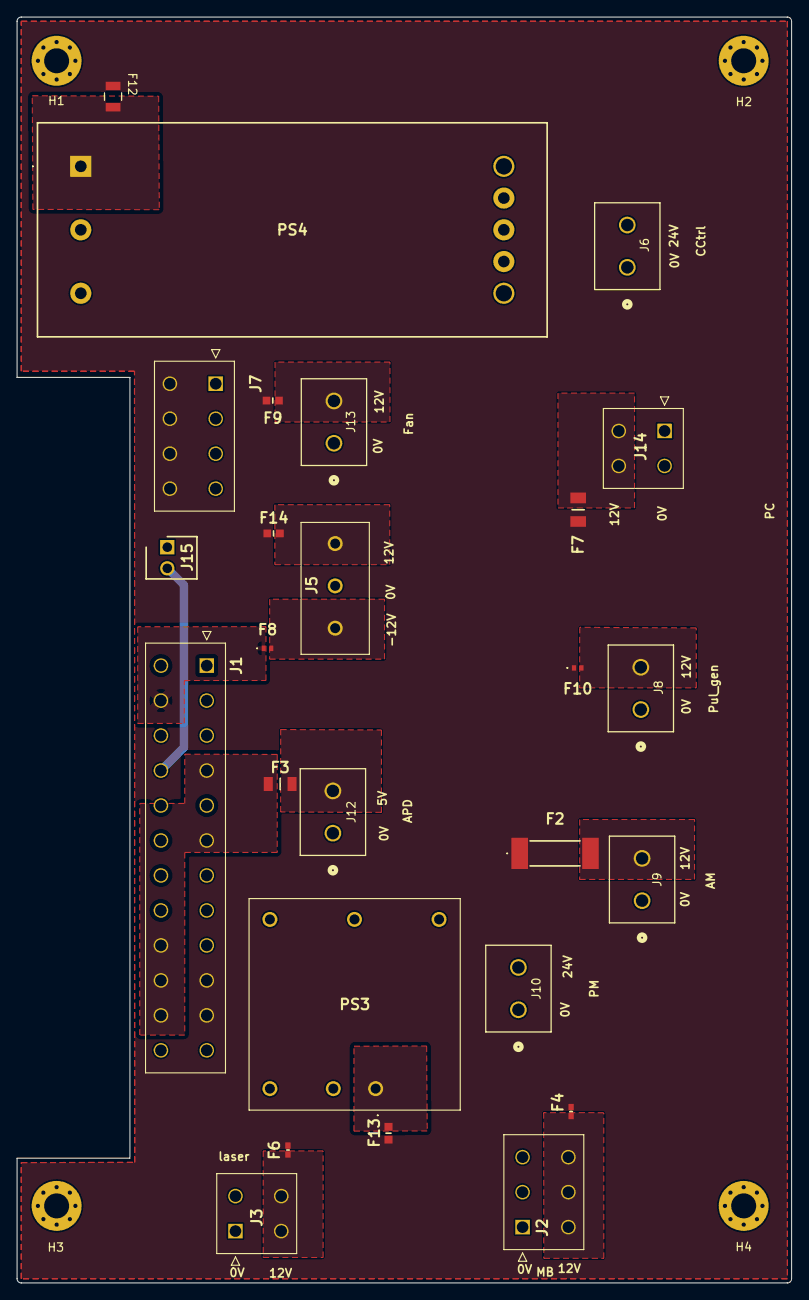
[picture p26: board supply_interface.kicad_pcb from above]

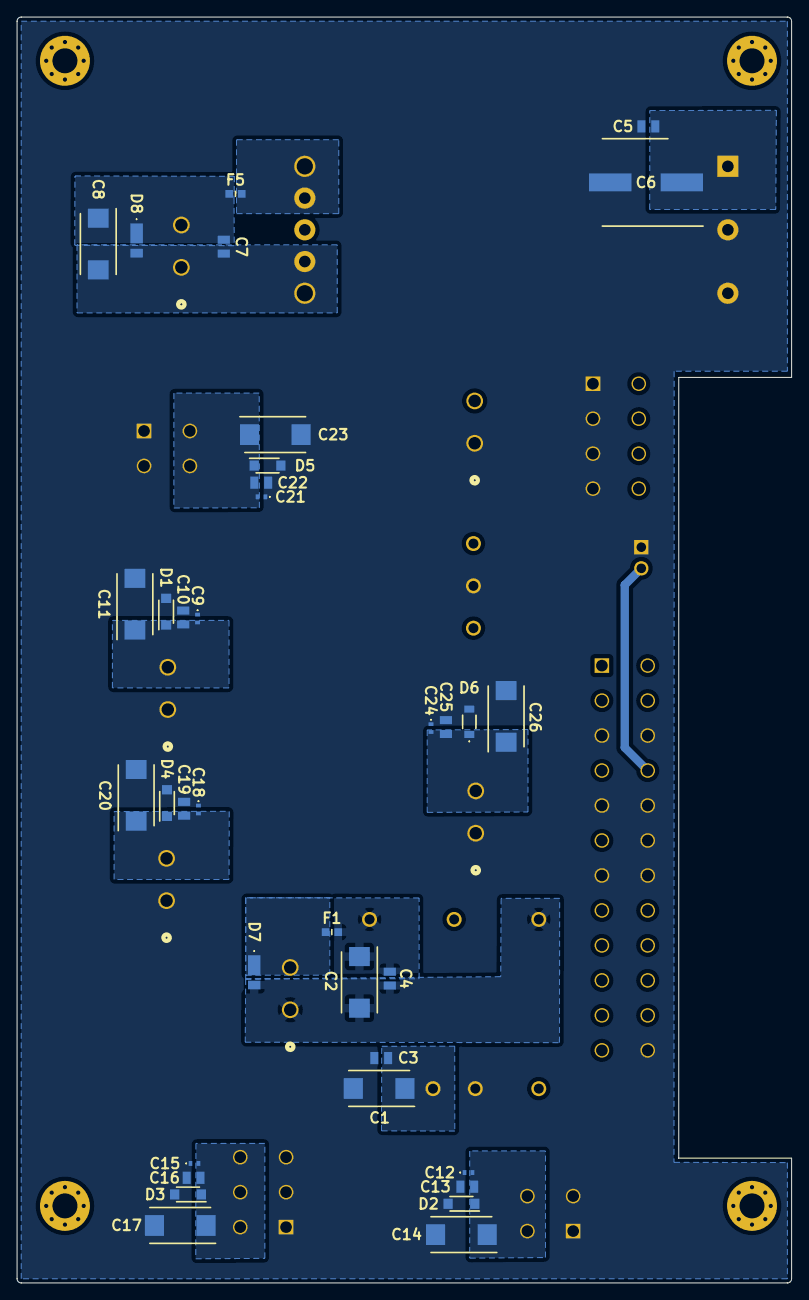
[picture p27: board supply_interface.kicad_pcb from below]

Board: 2 copper layers, 93.0 x 152.0 mm, 66 parts (36 on the bottom side), 23 nets.
