Veriqloud/kiwi_pcb/(commit log)

2024-12-16 Added libraries
    [PDN_Bread.ods]
2025-01-17 add supply_interface PCB design
    [supply_interface-B_Cu.gbr, supply_interface-B_Mask.gbr, supply_interface-B_Paste.gbr, supply_interface-B_Silkscreen.gbr, supply_interface-Edge_Cuts.gbr, supply_interface-F_Cu.gbr, supply_interface-F_Mask.gbr, supply_interface-F_Paste.gbr]
2026-05-29 Update supply interface
    [supply_interface.csv, supply_interface.kicad_pcb]
2026-06-04 Add TVS protection and decoupling capacitors for power rails
    [supply_interface.csv, supply_interface.kicad_pcb, supply_interface.kicad_sch]
2026-06-04 update ps_on connector
2026-06-11 update2 ps_on connector
    [supply_interface.csv, supply_interface.kicad_pcb, supply_interface.kicad_sch]
2026-06-19 Update PCB files and production outputs
    [supply_interface.csv, supply_interface.xlsx]
2026-07-02 Update supply interface KiCad project and external libraries
    [supply_interface.kicad_pcb, supply_interface.kicad_sch]
2026-07-03 update computer fuse
    [supply_interface.csv, supply_interface.kicad_pcb, supply_interface.kicad_sch]
2026-07-03 Update supply_interface PCB, production files and Gerbers
    [supply_interface-B_Cu.gbr, supply_interface-B_Mask.gbr, supply_interface-B_Paste.gbr, supply_interface-B_Silkscreen.gbr, supply_interface-Edge_Cuts.gbr, supply_interface-F_Cu.gbr, supply_interface-F_Mask.gbr, supply_interface-F_Paste.gbr]
2026-07-09 Update J14
    [supply_interface-B_Cu.gbr, supply_interface-B_Mask.gbr, supply_interface-B_Paste.gbr, supply_interface-B_Silkscreen.gbr, supply_interface-Edge_Cuts.gbr, supply_interface-F_Cu.gbr, supply_interface-F_Mask.gbr, supply_interface-F_Paste.gbr]
2026-07-27 Update board_shape
    [supply_interface-B_Cu.gbr, supply_interface-B_Mask.gbr, supply_interface-B_Paste.gbr, supply_interface-B_Silkscreen.gbr, supply_interface-Edge_Cuts.gbr, supply_interface-F_Cu.gbr, supply_interface-F_Mask.gbr, supply_interface-F_Paste.gbr]
